dczia/Defcon26-Badge/Hardware/KeyGridProto/KeyGridProto.kicad_pcb

## KiCad design Hardware/KeyGridProto/KeyGridProto.kicad_pcb (2018-03-29)

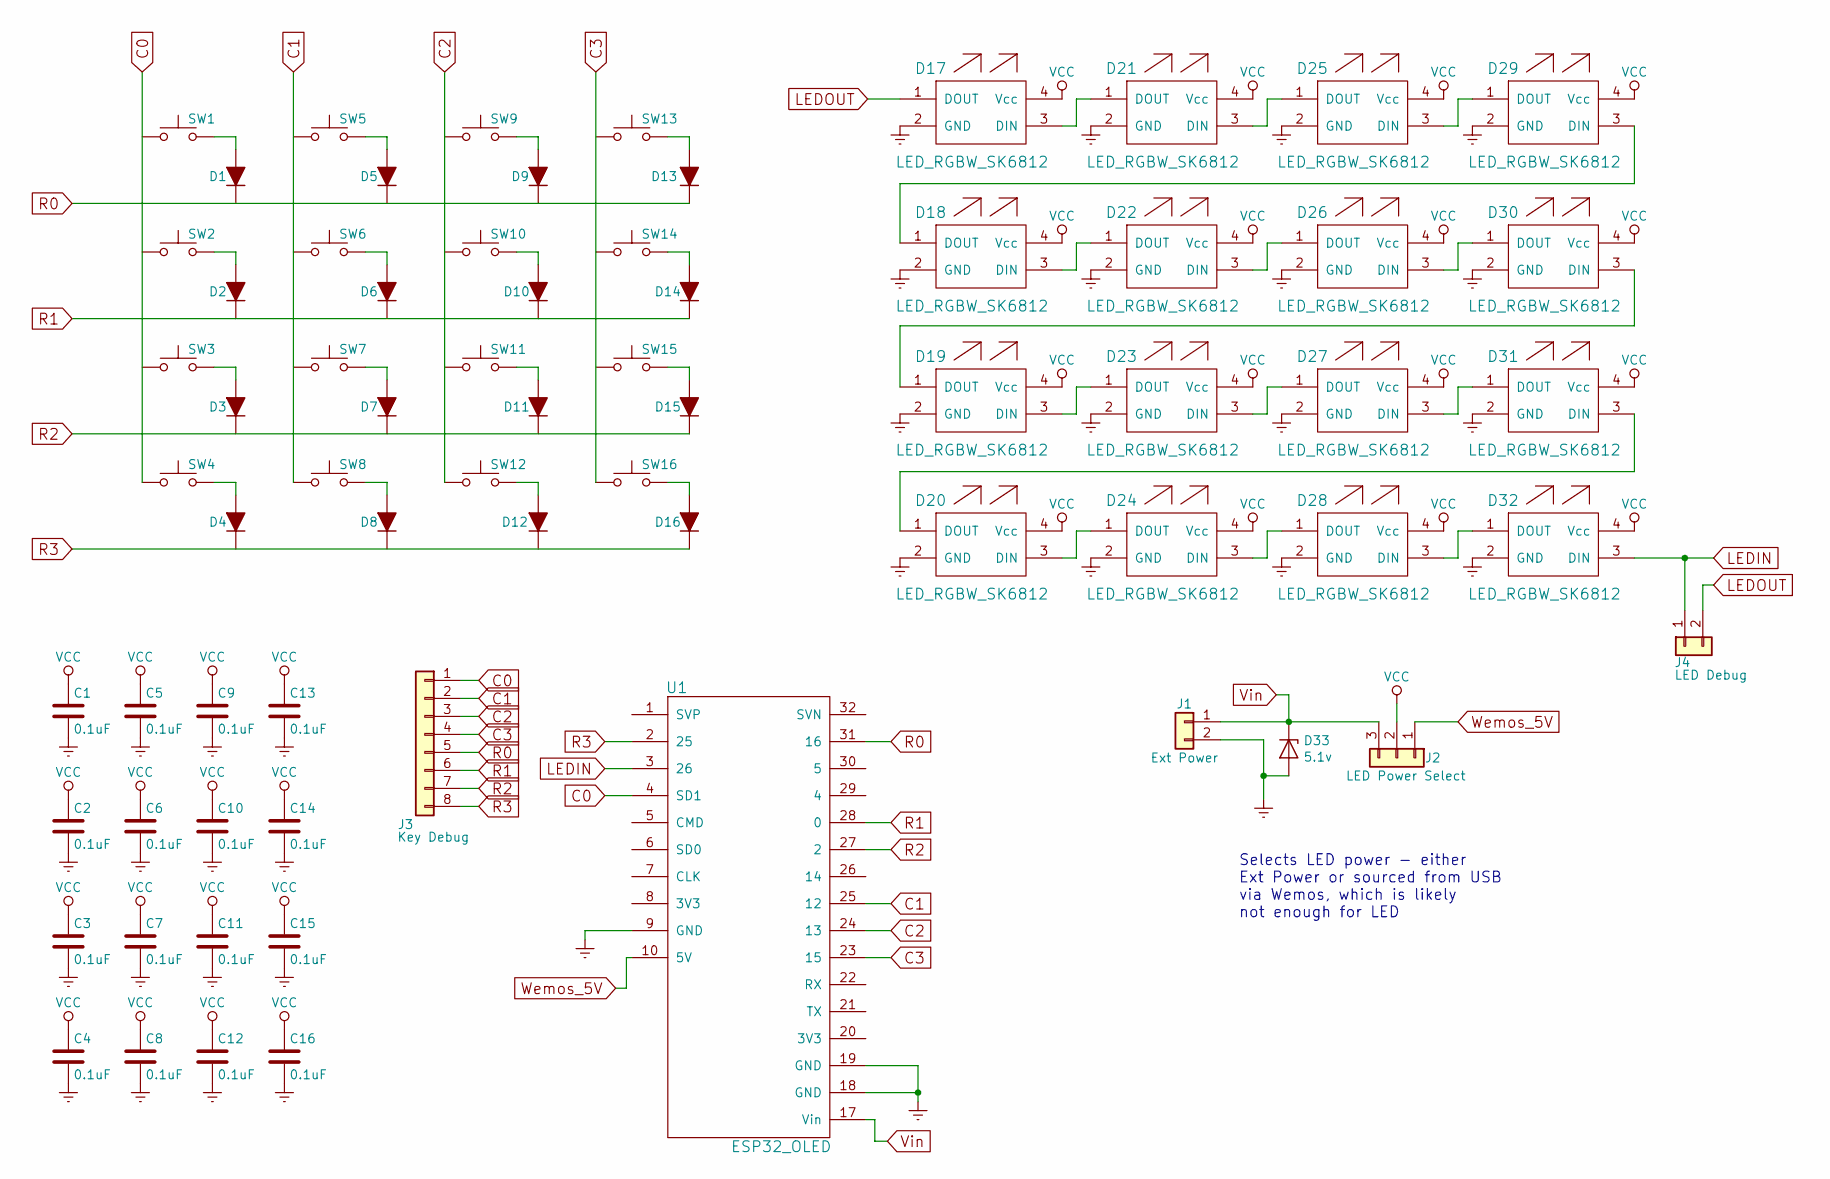
[picture p3: schematic KeyGridProto.sch]

Parts:
C1, C2, C3, C4, C5, C6, C7, C8, C9, C10, C11, C12, C13, C14, C15, C16: 0.1uF; C_0805_HandSoldering
D1, D2, D3, D4, D5, D6, D7, D8, D9, D10, D11, D12, D13, D14, D15, D16: D_ALT; D_SOD-123-New
D17, D18, D19, D20, D21, D22, D23, D24, D25, D26, D27, D28, D29, D30, D31, D32: LED_RGBW_SK6812; LED_RGB_3535
D33: 5.1v; D_SOD-123-New
J1: Ext Power; TE_Modular_2.5_Screwless
J2: LED Power Select; Pin_Header_Straight_1x03_Pitch2.54mm
J3: Key Debug; Pin_Header_Straight_1x08_Pitch2.54mm
J4: LED Debug; Pin_Header_Straight_1x02_Pitch2.54mm
SW1, SW2, SW3, SW4, SW5, SW6, SW7, SW8, SW9, SW10, SW11, SW12, SW13, SW14, SW15, SW16: SW_Push; CHERRY_SMDLED_100H
U1: ESP32_OLED; WEMOS_OLED

Connections:
C0: J3.1, SW1.1, SW2.1, SW3.1, SW4.1, U1.4 (SD1)
C1: J3.2, SW5.1, SW6.1, SW7.1, SW8.1, U1.25 (12)
C2: J3.3, SW9.1, SW10.1, SW11.1, SW12.1, U1.24 (13)
C3: J3.4, SW13.1, SW14.1, SW15.1, SW16.1, U1.23 (15)
GNDREF: C1.2, C2.2, C3.2, C4.2, C5.2, C6.2, C7.2, C8.2, C9.2, C10.2, C11.2, C12.2, C13.2, C14.2, C15.2, C16.2, D17.2 (GND), D18.2 (GND), D19.2 (GND), D20.2 (GND), D21.2 (GND), D22.2 (GND), D23.2 (GND), D24.2 (GND), D25.2 (GND), D26.2 (GND), D27.2 (GND), D28.2 (GND), D29.2 (GND), D30.2 (GND), D31.2 (GND), D32.2 (GND), D33.2 (A), J1.2, U1.9 (GND), U1.18 (GND), U1.19 (GND)
LEDIN: D32.3 (DIN), J4.1, U1.3 (26)
LEDOUT: D17.1 (DOUT), J4.2
unnamed: D1.2 (A), SW1.2
unnamed: D2.2 (A), SW2.2
unnamed: D3.2 (A), SW3.2
unnamed: D4.2 (A), SW4.2
unnamed: D5.2 (A), SW5.2
unnamed: D6.2 (A), SW6.2
unnamed: D7.2 (A), SW7.2
unnamed: D8.2 (A), SW8.2
unnamed: D9.2 (A), SW9.2
unnamed: D10.2 (A), SW10.2
unnamed: D11.2 (A), SW11.2
unnamed: D12.2 (A), SW12.2
unnamed: D13.2 (A), SW13.2
unnamed: D14.2 (A), SW14.2
unnamed: D15.2 (A), SW15.2
unnamed: D16.2 (A), SW16.2
unnamed: D17.3 (DIN), D21.1 (DOUT)
unnamed: D18.1 (DOUT), D29.3 (DIN)
unnamed: D18.3 (DIN), D22.1 (DOUT)
unnamed: D19.1 (DOUT), D30.3 (DIN)
unnamed: D19.3 (DIN), D23.1 (DOUT)
unnamed: D20.1 (DOUT), D31.3 (DIN)
unnamed: D20.3 (DIN), D24.1 (DOUT)
unnamed: D21.3 (DIN), D25.1 (DOUT)
unnamed: D22.3 (DIN), D26.1 (DOUT)
unnamed: D23.3 (DIN), D27.1 (DOUT)
unnamed: D24.3 (DIN), D28.1 (DOUT)
unnamed: D25.3 (DIN), D29.1 (DOUT)
unnamed: D26.3 (DIN), D30.1 (DOUT)
unnamed: D27.3 (DIN), D31.1 (DOUT)
unnamed: D28.3 (DIN), D32.1 (DOUT)
R0: D1.1 (K), D5.1 (K), D9.1 (K), D13.1 (K), J3.5, U1.31 (16)
R1: D2.1 (K), D6.1 (K), D10.1 (K), D14.1 (K), J3.6, U1.28 (0)
R2: D3.1 (K), D7.1 (K), D11.1 (K), D15.1 (K), J3.7, U1.27 (2)
R3: D4.1 (K), D8.1 (K), D12.1 (K), D16.1 (K), J3.8, U1.2 (25)
VCC: C1.1, C2.1, C3.1, C4.1, C5.1, C6.1, C7.1, C8.1, C9.1, C10.1, C11.1, C12.1, C13.1, C14.1, C15.1, C16.1, D17.4 (Vcc), D18.4 (Vcc), D19.4 (Vcc), D20.4 (Vcc), D21.4 (Vcc), D22.4 (Vcc), D23.4 (Vcc), D24.4 (Vcc), D25.4 (Vcc), D26.4 (Vcc), D27.4 (Vcc), D28.4 (Vcc), D29.4 (Vcc), D30.4 (Vcc), D31.4 (Vcc), D32.4 (Vcc), J2.2
Vin: D33.1 (K), J1.1, J2.3, U1.17 (Vin)
Wemos_5V: J2.1, U1.10 (5V)

Notes on the sheet:
Selects LED power - either Ext Power or sourced from USB via Wemos, which is likely not enough for LED

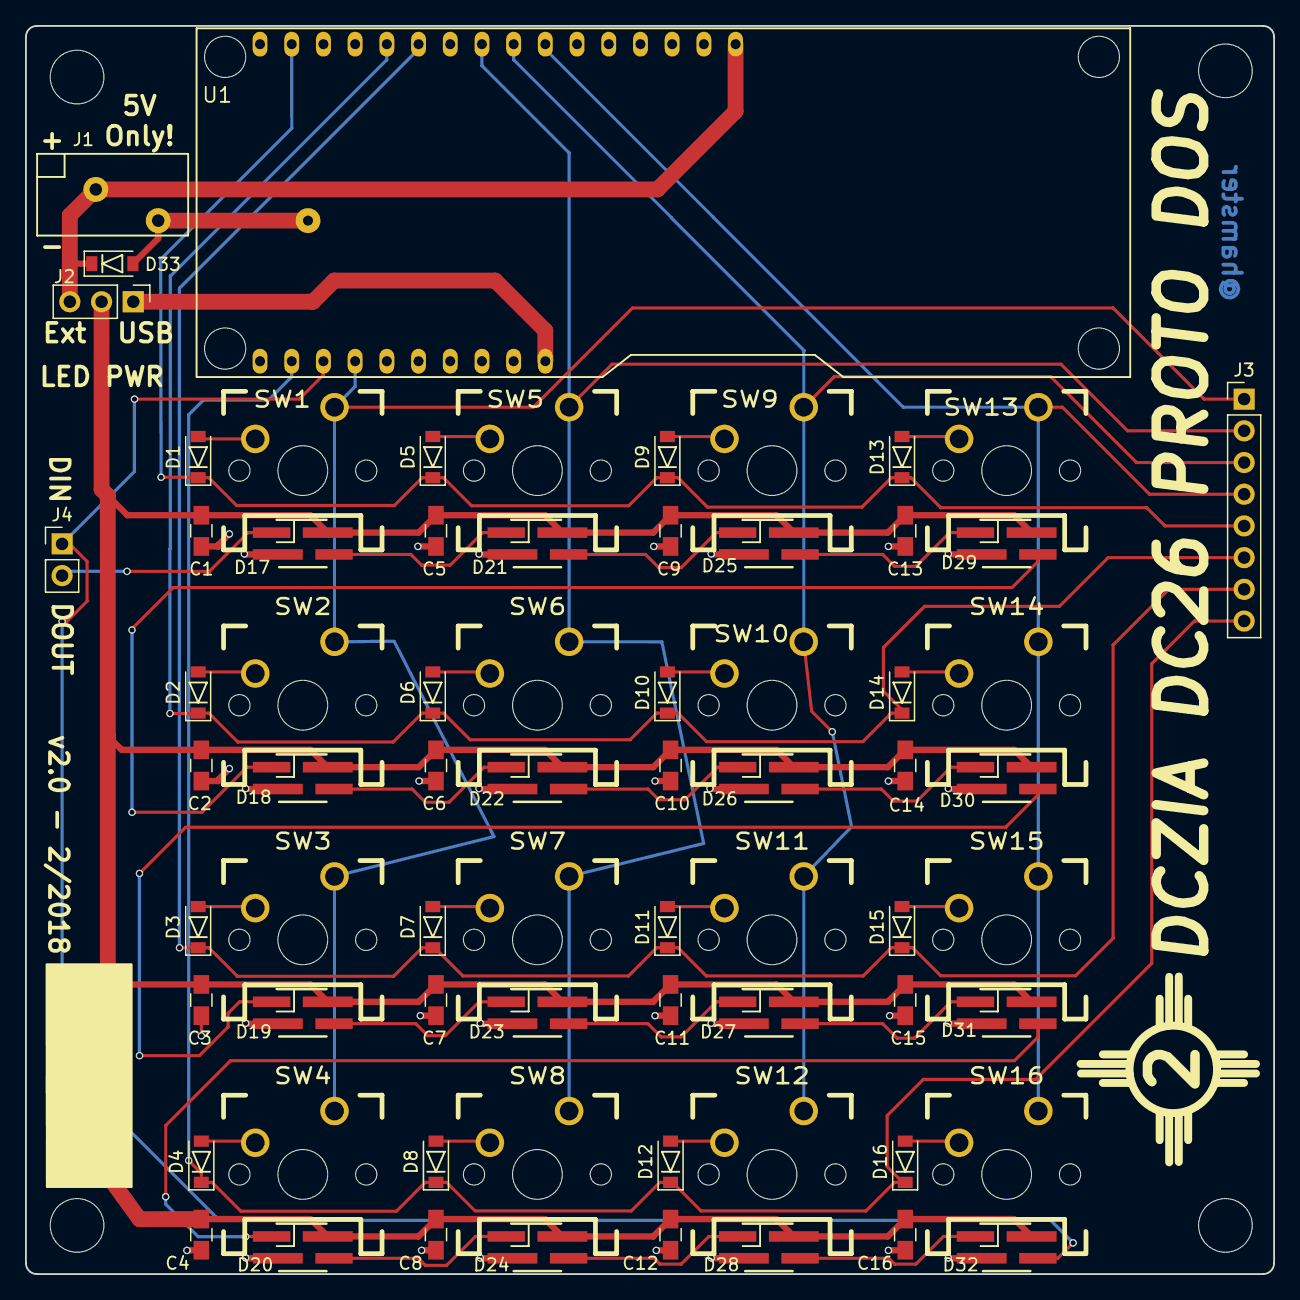
[picture p4: board KeyGridProto.kicad_pcb from above]

Board: 2 copper layers, 100.0 x 100.0 mm, 70 parts (0 on the bottom side), 45 nets.
